OpenElectronicsLab/OpenHardwareExG_Shield/README

The OpenHardwareExG_Shield is a platform for ECG, EEG, EMG, ENG, EOG, and
evoked potential applications using an Arduino.

http://openelectronicslab.github.io/OpenHardwareExG_Shield/

Example firmware can be found at:

https://github.com/OpenElectronicsLab/OpenHardwareExG_Shield_Arduino_Library
