OpenElectronicsLab/OpenHardwareExG_Shield/OpenHardwareExG_Shield_Test_Harness/kicad-files/OpenHardwareExG_Shield_Test_Board.bom.csv

ref | value | footprint | partnum | supplier
C1 | 10uF | SM0805 | LMK212B7106KG-TD | mouser
C2 | 100nF | SM0603 | VJ0603Y104JXJPW1BC | mouser
C3 | 100nF | SM0603 | VJ0603Y104JXJPW1BC | mouser
C4 | 100nF | SM0603 | VJ0603Y104JXJPW1BC | mouser
C5 | 10uF | SM0805 | LMK212B7106KG-TD | mouser
C6 | 100nF | SM0603 | VJ0603Y104JXJPW1BC | mouser
C7 | 100nF | SM0603 | VJ0603Y104JXJPW1BC | mouser
C8 | 100nF | SM0603 | VJ0603Y104JXJPW1BC | mouser
C9 | 100nF | SM0603 | VJ0603Y104JXJPW1BC | mouser
C10 | 10uF | SM0805 | LMK212B7106KG-TD | mouser
C11 | 10uF | SM0805 | LMK212B7106KG-TD | mouser
C12 | 100nF | SM0603 | VJ0603Y104JXJPW1BC | mouser
D1 | LED | LED-0603 | HT-193UYG-5592 | mouser
D2 | LED | LED-0603 | HT-193UYG-5592 | mouser
D3 | LED | LED-0603 | APTD1608SURCK | mouser
L1 | MH2029-221Y | SM0805 | MH2029-221Y | mouser
L3 | MH2029-221Y | SM0805 | MH2029-221Y | mouser
L4 | MH2029-221Y | SM0805 | MH2029-221Y | mouser
P1 | CONN_1 | POGO_PIN_BASE | PRT-09173 | sparkfun
P2 | CONN_1 | POGO_PIN_BASE | PRT-09173 | sparkfun
P3 | CONN_1 | POGO_PIN_BASE | PRT-09173 | sparkfun
P4 | CONN_1 | POGO_PIN_BASE | PRT-09173 | sparkfun
P5 | CONN_1 | POGO_PIN_BASE | PRT-09173 | sparkfun
P6 | CONN_1 | POGO_PIN_BASE | PRT-09173 | sparkfun
P7 | CONN_1 | POGO_PIN_BASE | PRT-09173 | sparkfun
P8 | CONN_1 | POGO_PIN_BASE | PRT-09173 | sparkfun
P9 | CONN_1 | POGO_PIN_BASE | PRT-09173 | sparkfun
P11 | CONN_1 | POGO_PIN_BASE | PRT-09173 | sparkfun
P12 | CONN_1 | POGO_PIN_BASE | PRT-09173 | sparkfun
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
R43 | 10k | SM0603 | RR0816P-103-D | mouser
R44 | 10k | SM0603 | RR0816P-103-D | mouser
SW1 | SW_PUSH | smt-tactile-button | B3SN-3012P | mouser
U1 | 74HC165 | SO16E | SN74HC165DR | mouser
U2 | 74HC165 | SO16E | SN74HC165DR | mouser
U3 | 74HC595PWR | TSSOP16 | SN74HC595PWR | mouser
U4 | 74HC165 | SO16E | SN74HC165DR | mouser
U5 | 74LS125 | SO14E | SN74LS125AD | mouser
U6 | TPS2095D | SO16E | TPS2095D | mouser
U8 | SI8661 | SO16W | Si8661BD-B-IS | mouser
