OpenElectronicsLab/OpenHardwareExG_Shield/kicad-files/ancillary-files/OpenHardwareExG_Shield-schematic.pdf

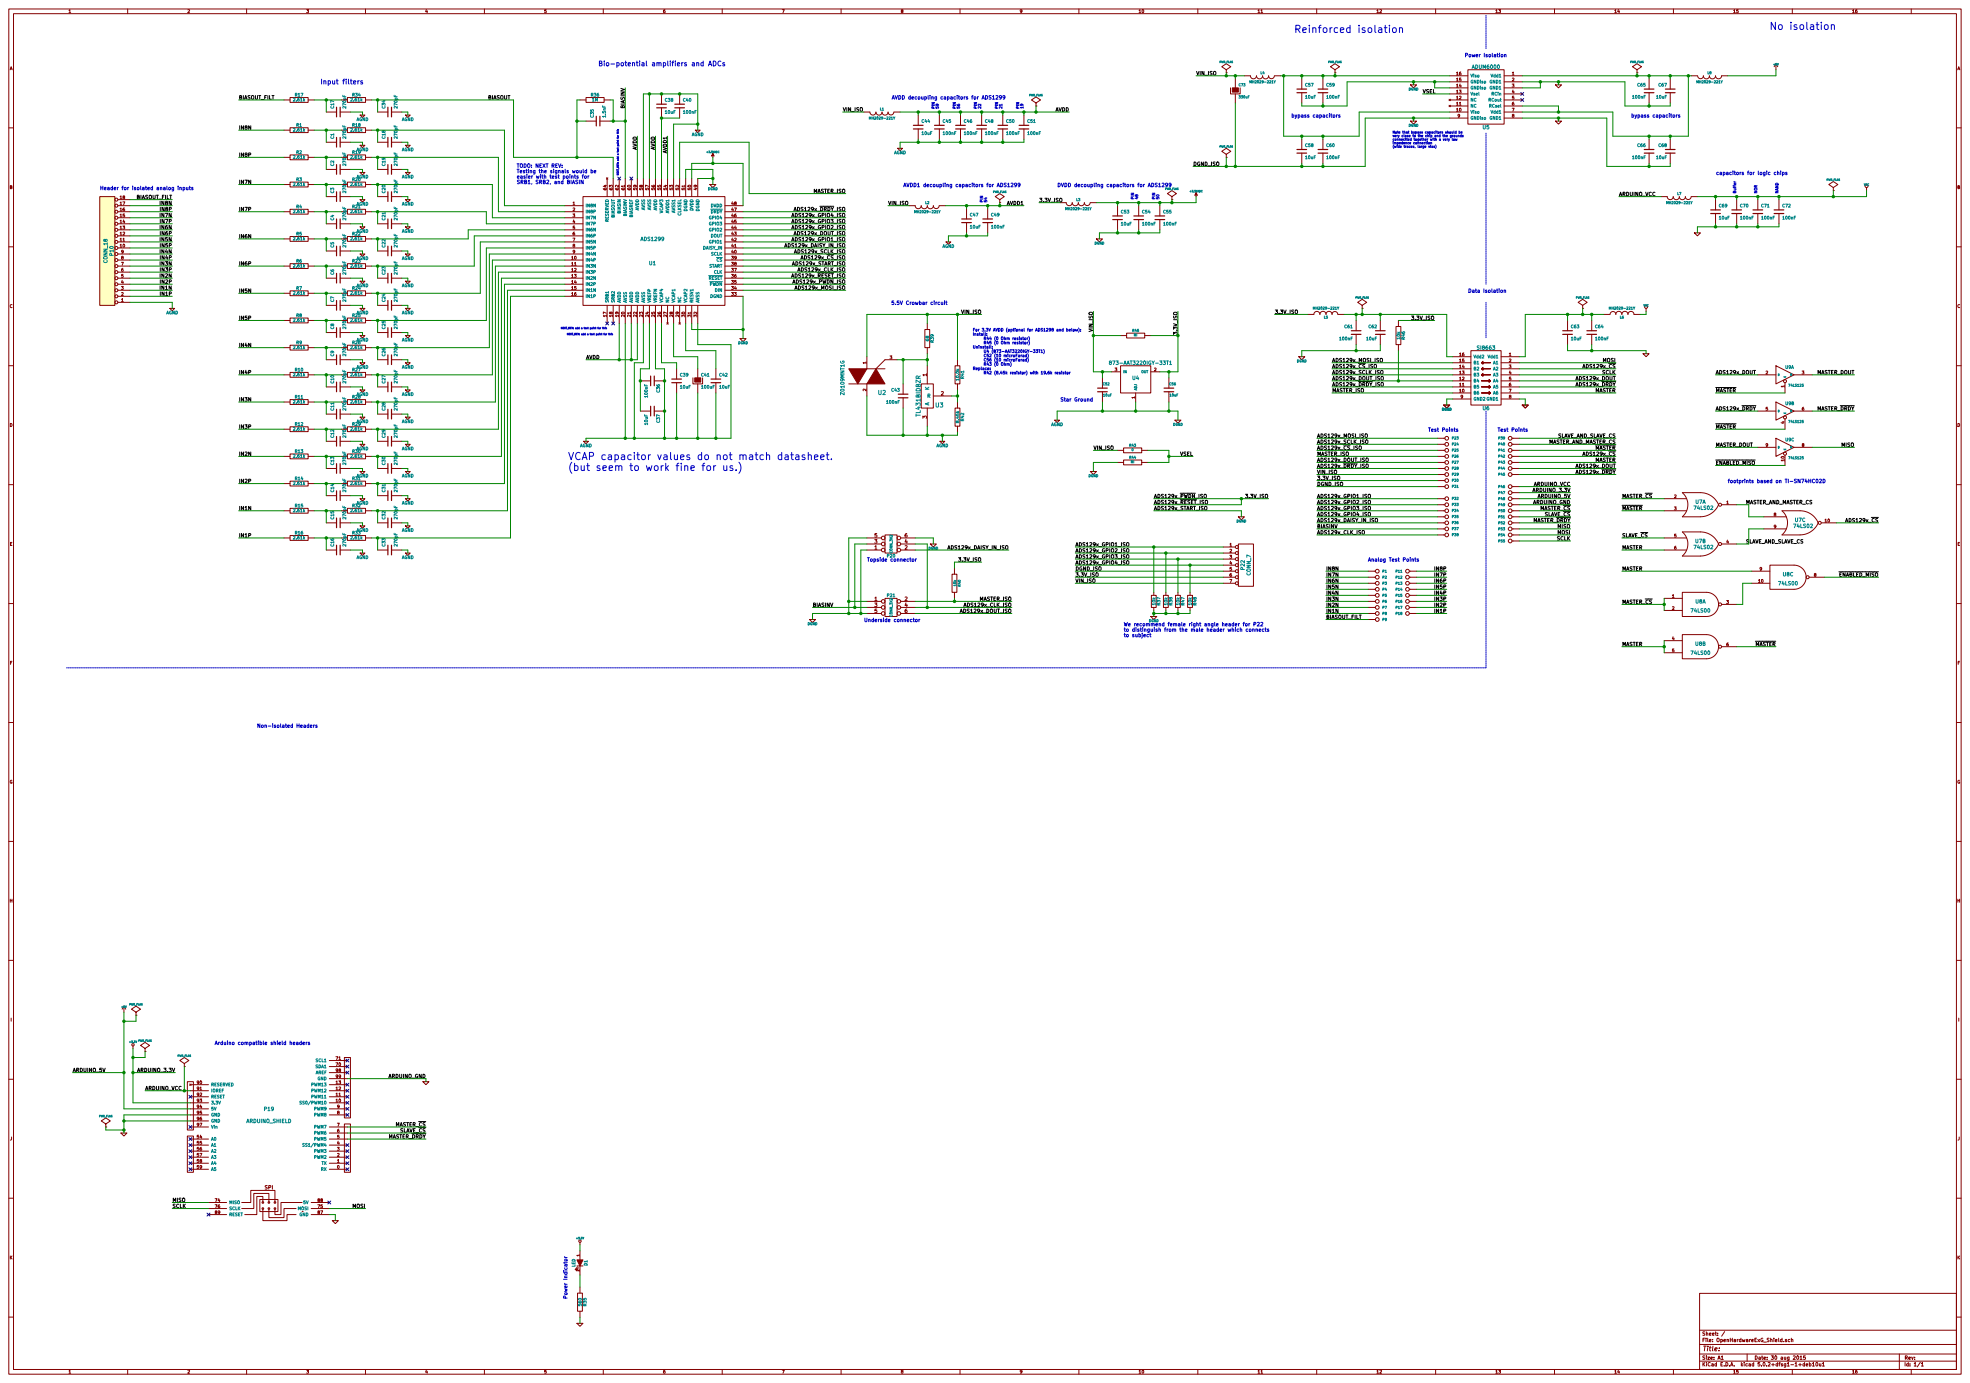
[picture p1: page 1]

(wide traces, large vias) VIN_ISO

Note that bypass capacitors should be
very close to the chip and the grounds
connectted together with a very low
impedence connection

DGND_ISO NEXT_REV: add a test point for this NEXT_REV: add a test point for this NEXT_REV: add a test point for this TODO: NEXT REV:

Testing the signals would be
easier with test points for

DVDD decoupling capacitors for ADS1299 C53

Header for isolated analog inputs
18 P10 CONN_18

For 3.3V AVDD (optional for ADS1298 and below):
Install:
R44 (0 Ohm resistor)
R45 (0 Ohm resistor) Uninstall:
U4 (873-AAT3220IGY-33T1)
C52 (10 microFarad)
C56 (10 microFarad)
R43 (0 Ohm) Replace:
R42 (8.45k resistor) with 19.6k resistor

VCAP capacitor values do not match datasheet.
(but seem to work fine for us.)

footprints based on TI-SN74HC02D

We recommend female right angle header for P22
to distinguish from the male header which connects
to subject

Non-isolated Headers Arduino compatible shield headers
