OpenElectronicsLab/OpenHardwareExG_Shield/OpenHardwareExG_Shield_Test_Harness/kicad-files/OpenHardwareExG_Shield_Test_Board.kicad_pcb

## KiCad design OpenHardwareExG_Shield_Test_Harness/kicad-files/OpenHardwareExG_Shield_Test_Board.kicad_pcb (2015-10-03)

Schematic: OpenHardwareExG_Shield_Test_Board.sch

Parts:
C1, C5, C10, C11: 10uF; SM0805
C2, C3, C4, C6, C7, C8, C9, C12: 100nF; SM0603
D1, D2, D3: LED; LED-0603
L1, L3, L4: MH2029-221Y; SM0805
P1, P2, P3, P4, P5, P6, P7, P8, P9, P11, P12, P13, P14, P15, P16, P17, P18, P23, P24, P25, P26, P27, P28, P29, P30, P31, P32, P33, P34, P35, P36, P37, P38, P39, P40, P41, P42, P43, P44, P45, P46, P47, P48, P49, P50, P51, P52, P53, P54, P55: CONN_1; POGO_PIN_BASE
P19: ARDUINO_SHIELD; arduino_shield_with_holes
P56: CONN_3X2; pin_array_3x2
P57: CONN_20X2; PIN_ARRAY_20X2
R1, R3, R5, R43, R44: 10k; SM0603
R2, R4, R6: 1k; SM0603
R7: 5.1K; SM0603
R8, R18, R19, R20, R21, R22, R23, R24, R25, R26, R27, R28, R29, R30, R31, R32: 100; SM0603
R9, R10, R11, R12, R13, R14, R15, R16, R34, R35, R36, R37, R38, R39: 1M; SM0805
R17, R33: 15k; SM0603
R40, R41, R42: 560; SM0603
SW1: SW_PUSH; smt-tactile-button
U1, U2, U4: 74HC165; SO16E
U3: 74HC595PWR; TSSOP16
U5: 74LS125; SO14E
U6: TPS2095D; SO16E
U8: SI8661; SO16W

Connections:
+3.3V: P19.93 (3.3V), U6.3 (IN2)
+5V: P19.88 (5V), P19.94 (5V), P56.4, U6.6 (IN3)
/3.3V_BOGUS_ISO: L1.2, P30.1, P57.3, P57.4, R3.1
/3.3V_BOGUS_ISO_DATA: C9.1, C10.1, L3.1, U8.16 (Vdd2)
/A1: P19.55 (A1), R5.2, R6.1
/A2: P19.56 (A2), R3.2, R4.1
/A3: P19.57 (A3), R1.2, R2.1
/A4: P19.58 (A4), R8.2
/ADS129x_CLK_BOGUS_ISO: P38.1, R35.1, U2.13 (C)
/ADS129x_DAISY_IN_BOGUS_ISO: P36.1, R34.1, U1.13 (C)
/ADS129x_DOUT: P44.1, U4.12 (B)
/ADS129x_DOUT_BOGUS_ISO: P27.1, R39.1, U2.11 (A)
/ADS129x_GPIO1_BOGUS_ISO: P32.1, R9.1, U1.3 (E)
/ADS129x_GPIO2_BOGUS_ISO: P33.1, R11.1, U1.4 (F)
/ADS129x_GPIO3_BOGUS_ISO: P34.1, R13.1, U1.5 (G)
/ADS129x_GPIO4_BOGUS_ISO: P35.1, R15.1, U1.6 (H)
/ADS129x_MOSI_BOGUS_ISO: P23.1, R10.1, U2.3 (E)
/ADS129x_SCLK_BOGUS_ISO: P24.1, R12.1, U2.4 (F)
/ADS129x_~CS~: P42.1, U4.14 (D)
/ADS129x_~CS~_BOGUS_ISO: P25.1, R14.1, U2.5 (G)
/ADS129x_~DRDY~: P45.1, U4.11 (A)
/ADS129x_~DRDY~_BOGUS_ISO: P28.1, R37.1, U2.12 (B)
/ARDUINO_VCC: C5.1, C6.1, C7.1, C8.1, D1.1, L4.2, P19.91 (IOREF), P56.2, R44.2, SW1.2, U3.16 (VCC), U4.16 (VCC), U6.2 (IN1)
/BIASINV: P37.1, R36.1, U1.12 (B)
/BIASOUT_FILT: P9.1, P19.59 (A5), R7.1
/ENABLE_SHIELD: U3.7 (QH), U6.4 (EN1), U6.8 (EN3), U6.13 (EN2)
/FAULT_LED: D3.1, U3.6 (QG)
/GO_BUTTON: R43.1, SW1.1, U4.6 (H)
/IN1N: P8.1, P57.37
/IN1N_LADDER: P57.38, R31.2, R32.2
/IN1P: P18.1, P57.39
/IN1P_LADDER: P57.40, R32.1, R33.1
/IN2N: P7.1, P57.33
/IN2N_LADDER: P57.34, R29.2, R30.2
/IN2P: P17.1, P57.35
/IN2P_LADDER: P57.36, R30.1, R31.1
/IN3N: P6.1, P57.29
/IN3N_LADDER: P57.30, R27.2, R28.2
/IN3P: P16.1, P57.31
/IN3P_LADDER: P57.32, R28.1, R29.1
/IN4N: P5.1, P57.25
/IN4N_LADDER: P57.26, R25.2, R26.2
/IN4P: P15.1, P57.27
/IN4P_LADDER: P57.28, R26.1, R27.1
/IN5N: P4.1, P57.21
/IN5N_LADDER: P57.22, R23.2, R24.2
/IN5P: P14.1, P57.23
/IN5P_LADDER: P57.24, R24.1, R25.1
/IN6N: P3.1, P57.17
/IN6N_LADDER: P57.18, R21.2, R22.2
/IN6P: P13.1, P57.19
/IN6P_LADDER: P57.20, R22.1, R23.1
/IN7N: P2.1, P57.13
/IN7N_LADDER: P57.14, R19.2, R20.2
/IN7P: P12.1, P57.15
/IN7P_LADDER: P57.16, R20.1, R21.1
/IN8N: P1.1, P57.9
/IN8N_LADDER: P57.10, R17.2, R18.2
/IN8P: P11.1, P57.11
/IN8P_LADDER: P57.12, R18.1, R19.1
/LED1: D1.2, R40.1
/LED2: D2.2, R41.1
/LED3: D3.2, R42.1
/MASTER: P43.1, U4.13 (C)
/MASTER_AND_MASTER_CS: P40.1, U4.4 (F)
/MASTER_BOGUS_ISO: P26.1, R16.1, U2.6 (H), U5.3 (O)
/MASTER_~CS~: P50.1, U3.1 (QB)
/MASTER_~DRDY~: P19.2 (PWM2), P52.1
/MIDDLE_CARRY: U1.9 (QH), U2.10 (SER)
/MISO: P19.74 (MISO), P53.1
/MOSI: P19.75 (MOSI), P54.1
/SCLK: P19.76 (SCLK), P55.1
/SHIELD_3.3V: P47.1, U6.14 (OUT2)
/SHIELD_5V: P48.1, U6.11 (OUT3)
/SHIELD_VCC: P46.1, U6.15 (OUT1)
/SHIFT_CARRY: U4.10 (SER), U8.7 (A6)
/SHIFT_CARRY_BOGUS_ISO: U2.9 (QH), U8.10 (B6)
/SHIFT_CLK: P19.8 (PWM8), U4.2 (CLK), U8.6 (A5)
/SHIFT_CLK_BOGUS_ISO: P56.3, U1.2 (CLK), U2.2 (CLK), U8.11 (B5)
/SHIFT_EXT_CARRY_BOGUS_ISO: P56.5, R38.1, U1.10 (SER)
/SHIFT_IN: P19.54 (A0), U4.9 (QH)
/SHIFT_OUT: P19.6 (PWM6), U3.14 (SER)
/SHIFT_OUT_RCLK: P19.5 (PWM5), U3.12 (RCLK)
/SHIFT_OUT_SRCLK: P19.4 (SS1/PWM4), U3.11 (SRCLK)
/SHIFT_OUT_~SRCLR~: P19.3 (PWM3), U3.10 (~SRCLR~)
/SHIFT_SH_~LD~: P19.9 (PWM9), U4.1 (SH_~LD~), U8.5 (A4)
/SHIFT_SH_~LD~_BOGUS_ISO: P56.1, U1.1 (SH_~LD~), U2.1 (SH_~LD~), U8.12 (B4)
/SIGNAL_A: U3.3 (QD), U8.2 (A1)
/SIGNAL_A_BOGUS_ISO: P57.6, U8.15 (B1)
/SIGNAL_A_LADDER: P57.5, R17.1
/SIGNAL_B: U3.4 (QE), U8.3 (A2)
/SIGNAL_B_BOGUS_ISO: P57.8, U8.14 (B2)
/SIGNAL_B_LADDER: P57.7, R33.2
/SLAVE_AND_SLAVE_CS: P39.1, U4.3 (E)
/SLAVE_~CS~: P51.1, U3.2 (QC)
/SUCCESS_LED: D2.1, U3.5 (QF)
/VCC_DATA: C11.1, C12.1, L4.1, U8.1 (Vdd1)
/VIN_BOGUS_ISO: P29.1, R5.1
/~MASTER~: P41.1, U4.5 (G)
/~SEND_TO_GND~_MASTER: U3.15 (QA), U8.4 (A3)
/~SEND_TO_GND~_MASTER_BOGUS_ISO: U5.1 (E), U8.13 (B3)
/~SHIELD_SHORTED~: P19.7 (PWM7), R44.1, U6.12 (~OCB~), U6.16 (~OCA~)
GND: C1.2, C2.2, C3.2, C4.2, C9.2, C10.2, P31.1, P57.1, P57.2, R1.1, R8.1, R9.2, R10.2, R11.2, R12.2, R13.2, R14.2, R15.2, R16.2, R34.2, R35.2, R36.2, R37.2, R38.2, R39.2, U1.8 (GND), U1.15 (CLK_INH), U2.8 (GND), U2.15 (CLK_INH), U5.2 (D), U5.7 (GND), U8.9 (GND2)
GNDPWR: C5.2, C6.2, C7.2, C8.2, C11.2, C12.2, P19.87 (GND), P19.95 (GND), P19.96 (GND), P19.99 (GND), P49.1, P56.6, R2.2, R4.2, R6.2, R7.2, R40.2, R41.2, R42.2, R43.2, U3.8 (GND), U3.13 (~OE~), U4.8 (GND), U4.15 (CLK_INH), U6.1 (GNDA), U6.5 (GNDB), U6.7 (IN4), U6.9 (EN4), U8.8 (GND1)
VCC: C1.1, C2.1, C3.1, C4.1, L1.1, L3.2, U1.11 (A), U1.14 (D), U1.16 (VCC), U2.14 (D), U2.16 (VCC), U5.14 (VCC)

Notes on the sheet:
Power Indicator
Non-isolated Headers
Arduino compatible shield headers
No isolation
bogus isolation
Bogus Data Isolation
Test Pogos
SHIFT
Buffer
capacitors for logic chips
Success Indicator
Fault Indicator

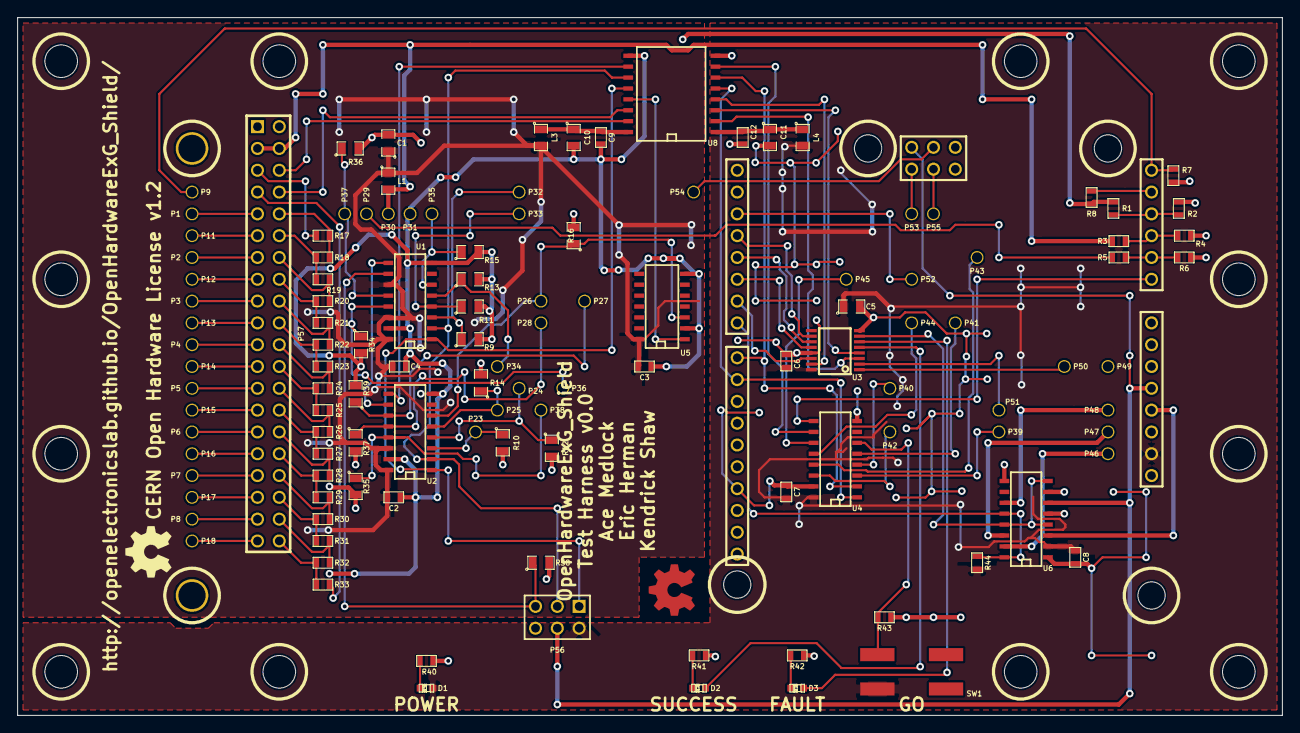
[picture p2: board OpenHardwareExG_Shield_Test_Board.kicad_pcb from above]

Board: 4 copper layers, 147.3 x 81.3 mm, 137 parts (0 on the bottom side), 105 nets.

Other parts of the board:
Hole_M3, Hole_M3#2, Hole_M3#3, Hole_M3#4, Hole_M3#5, Hole_M3#6, Hole_M3#7, Hole_M3#8, Hole_M3#9, Hole_M3#10, Hole_M3#11, Hole_M3#12, Hole_M3#13, Hole_M3#14: VAL**; Hole_M3
