OpenElectronicsLab/OpenHardwareExG_Shield/kicad-files/OpenHardwareExG_Shield.kicad_pcb

## KiCad design kicad-files/OpenHardwareExG_Shield.kicad_pcb (2016-09-04)

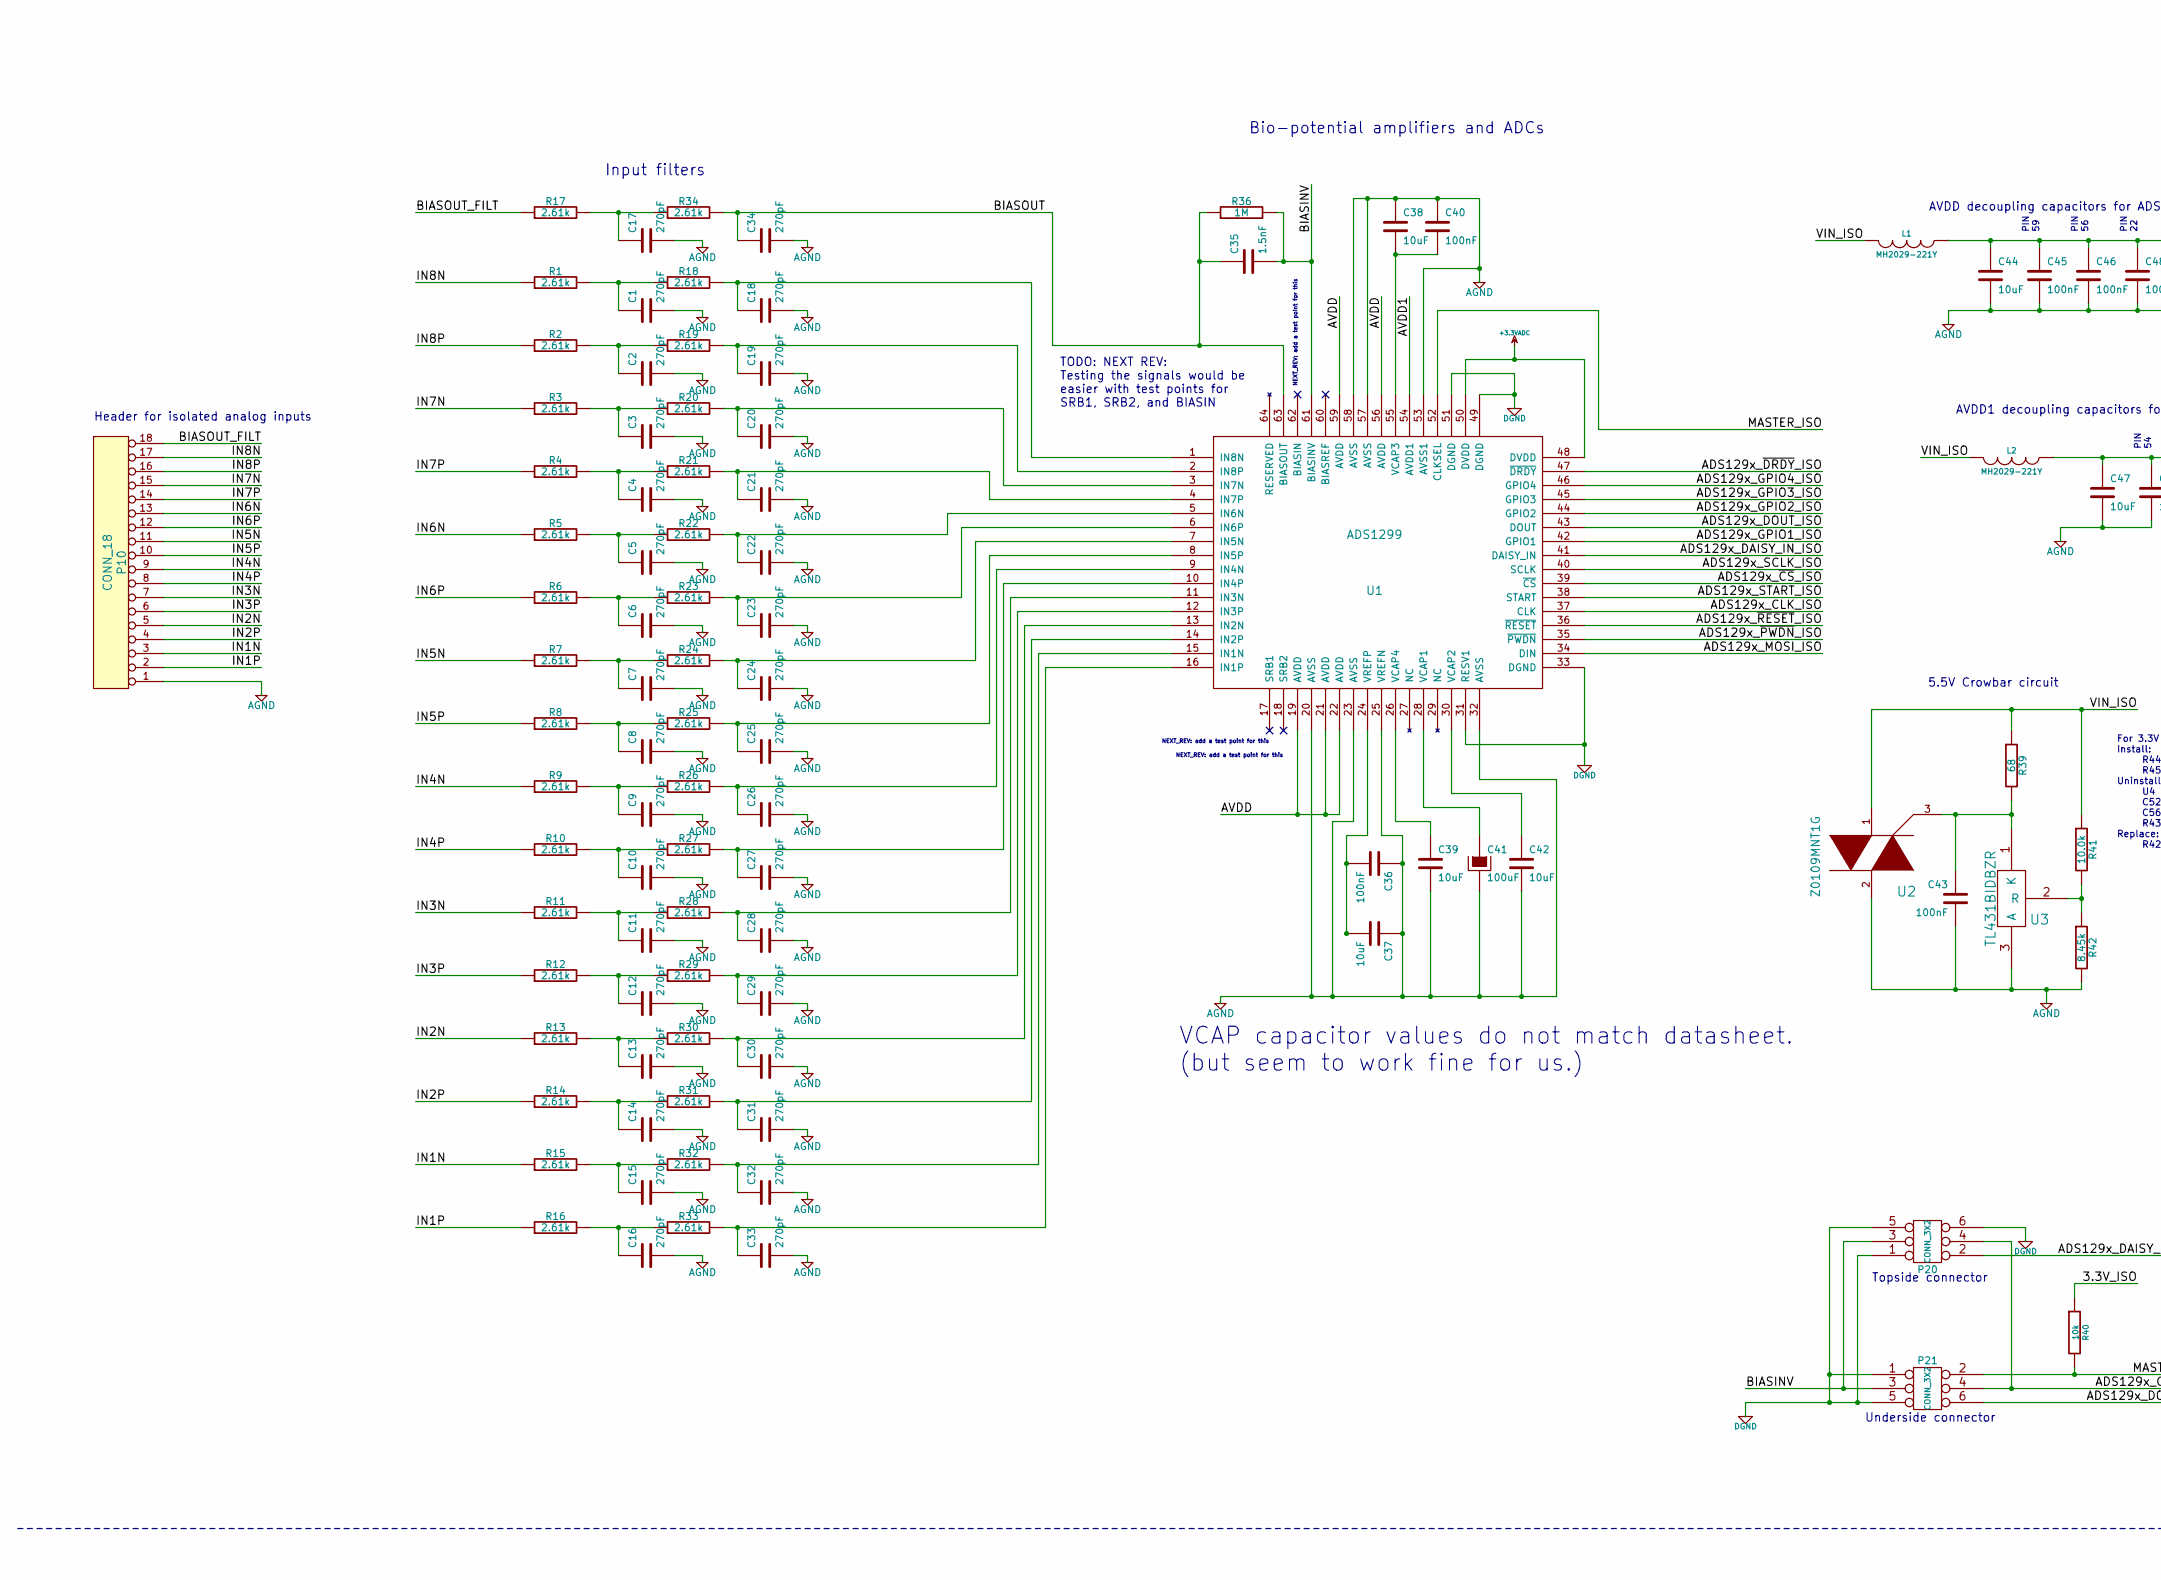
[picture p3: schematic OpenHardwareExG_Shield.sch, part in row 1, column 1]

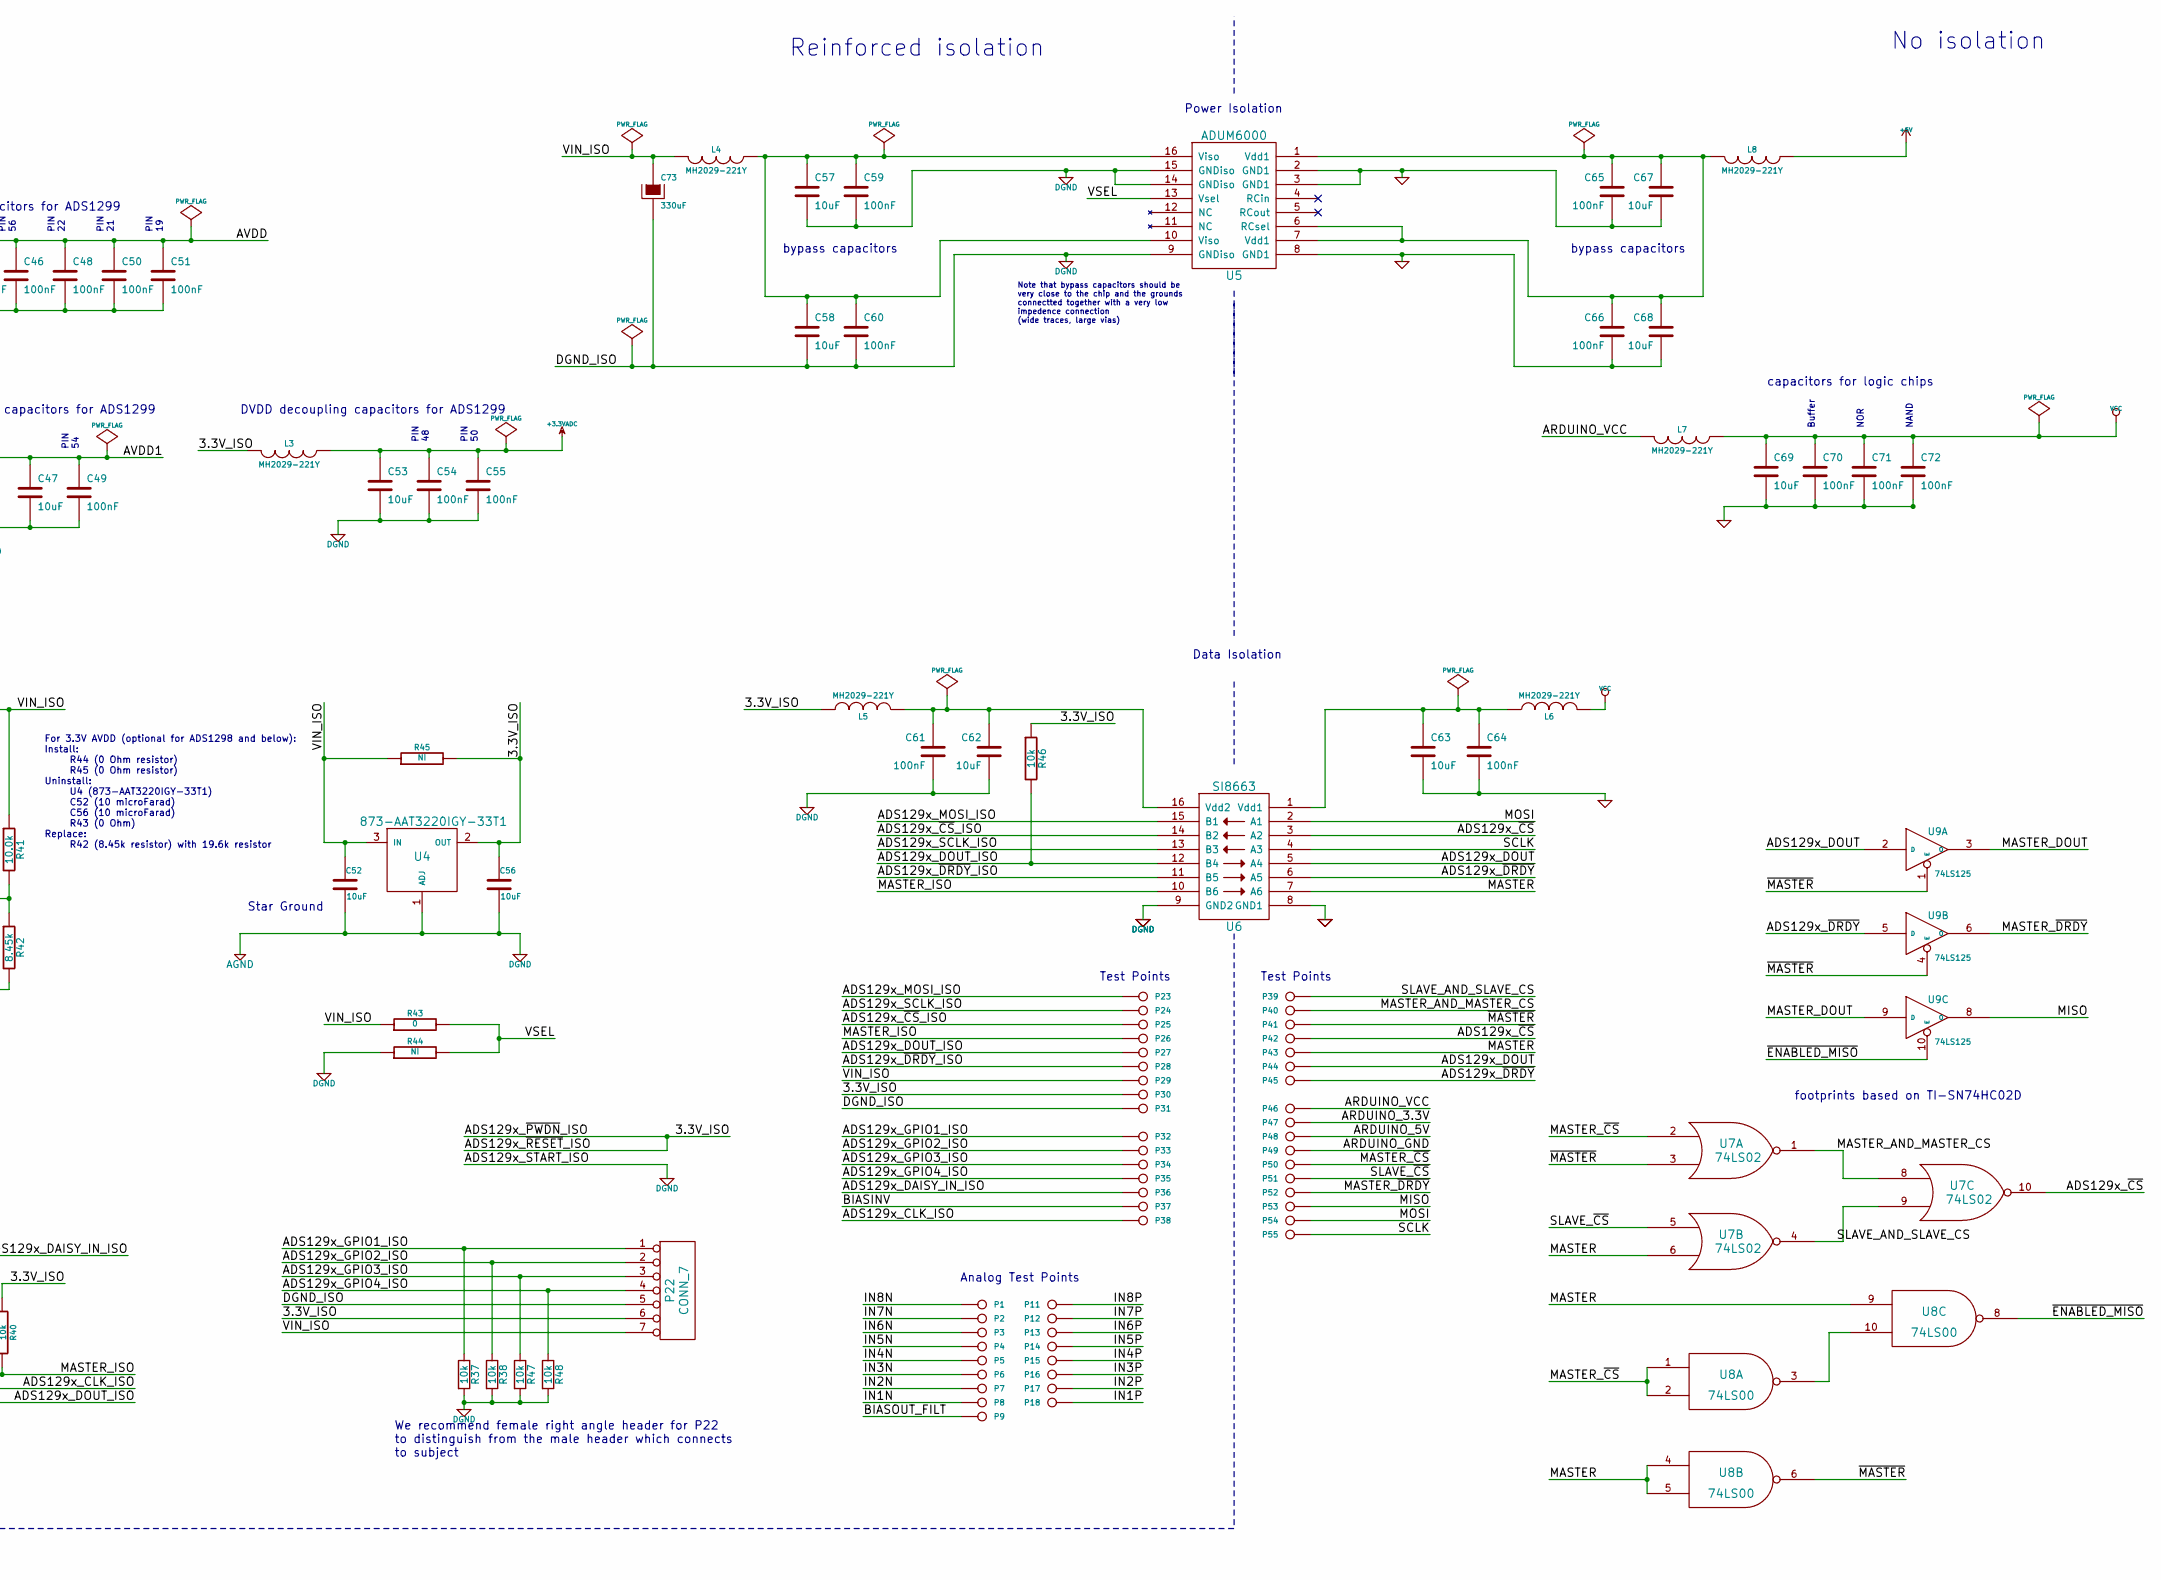
[picture p4: schematic OpenHardwareExG_Shield.sch, part in row 1, column 2]

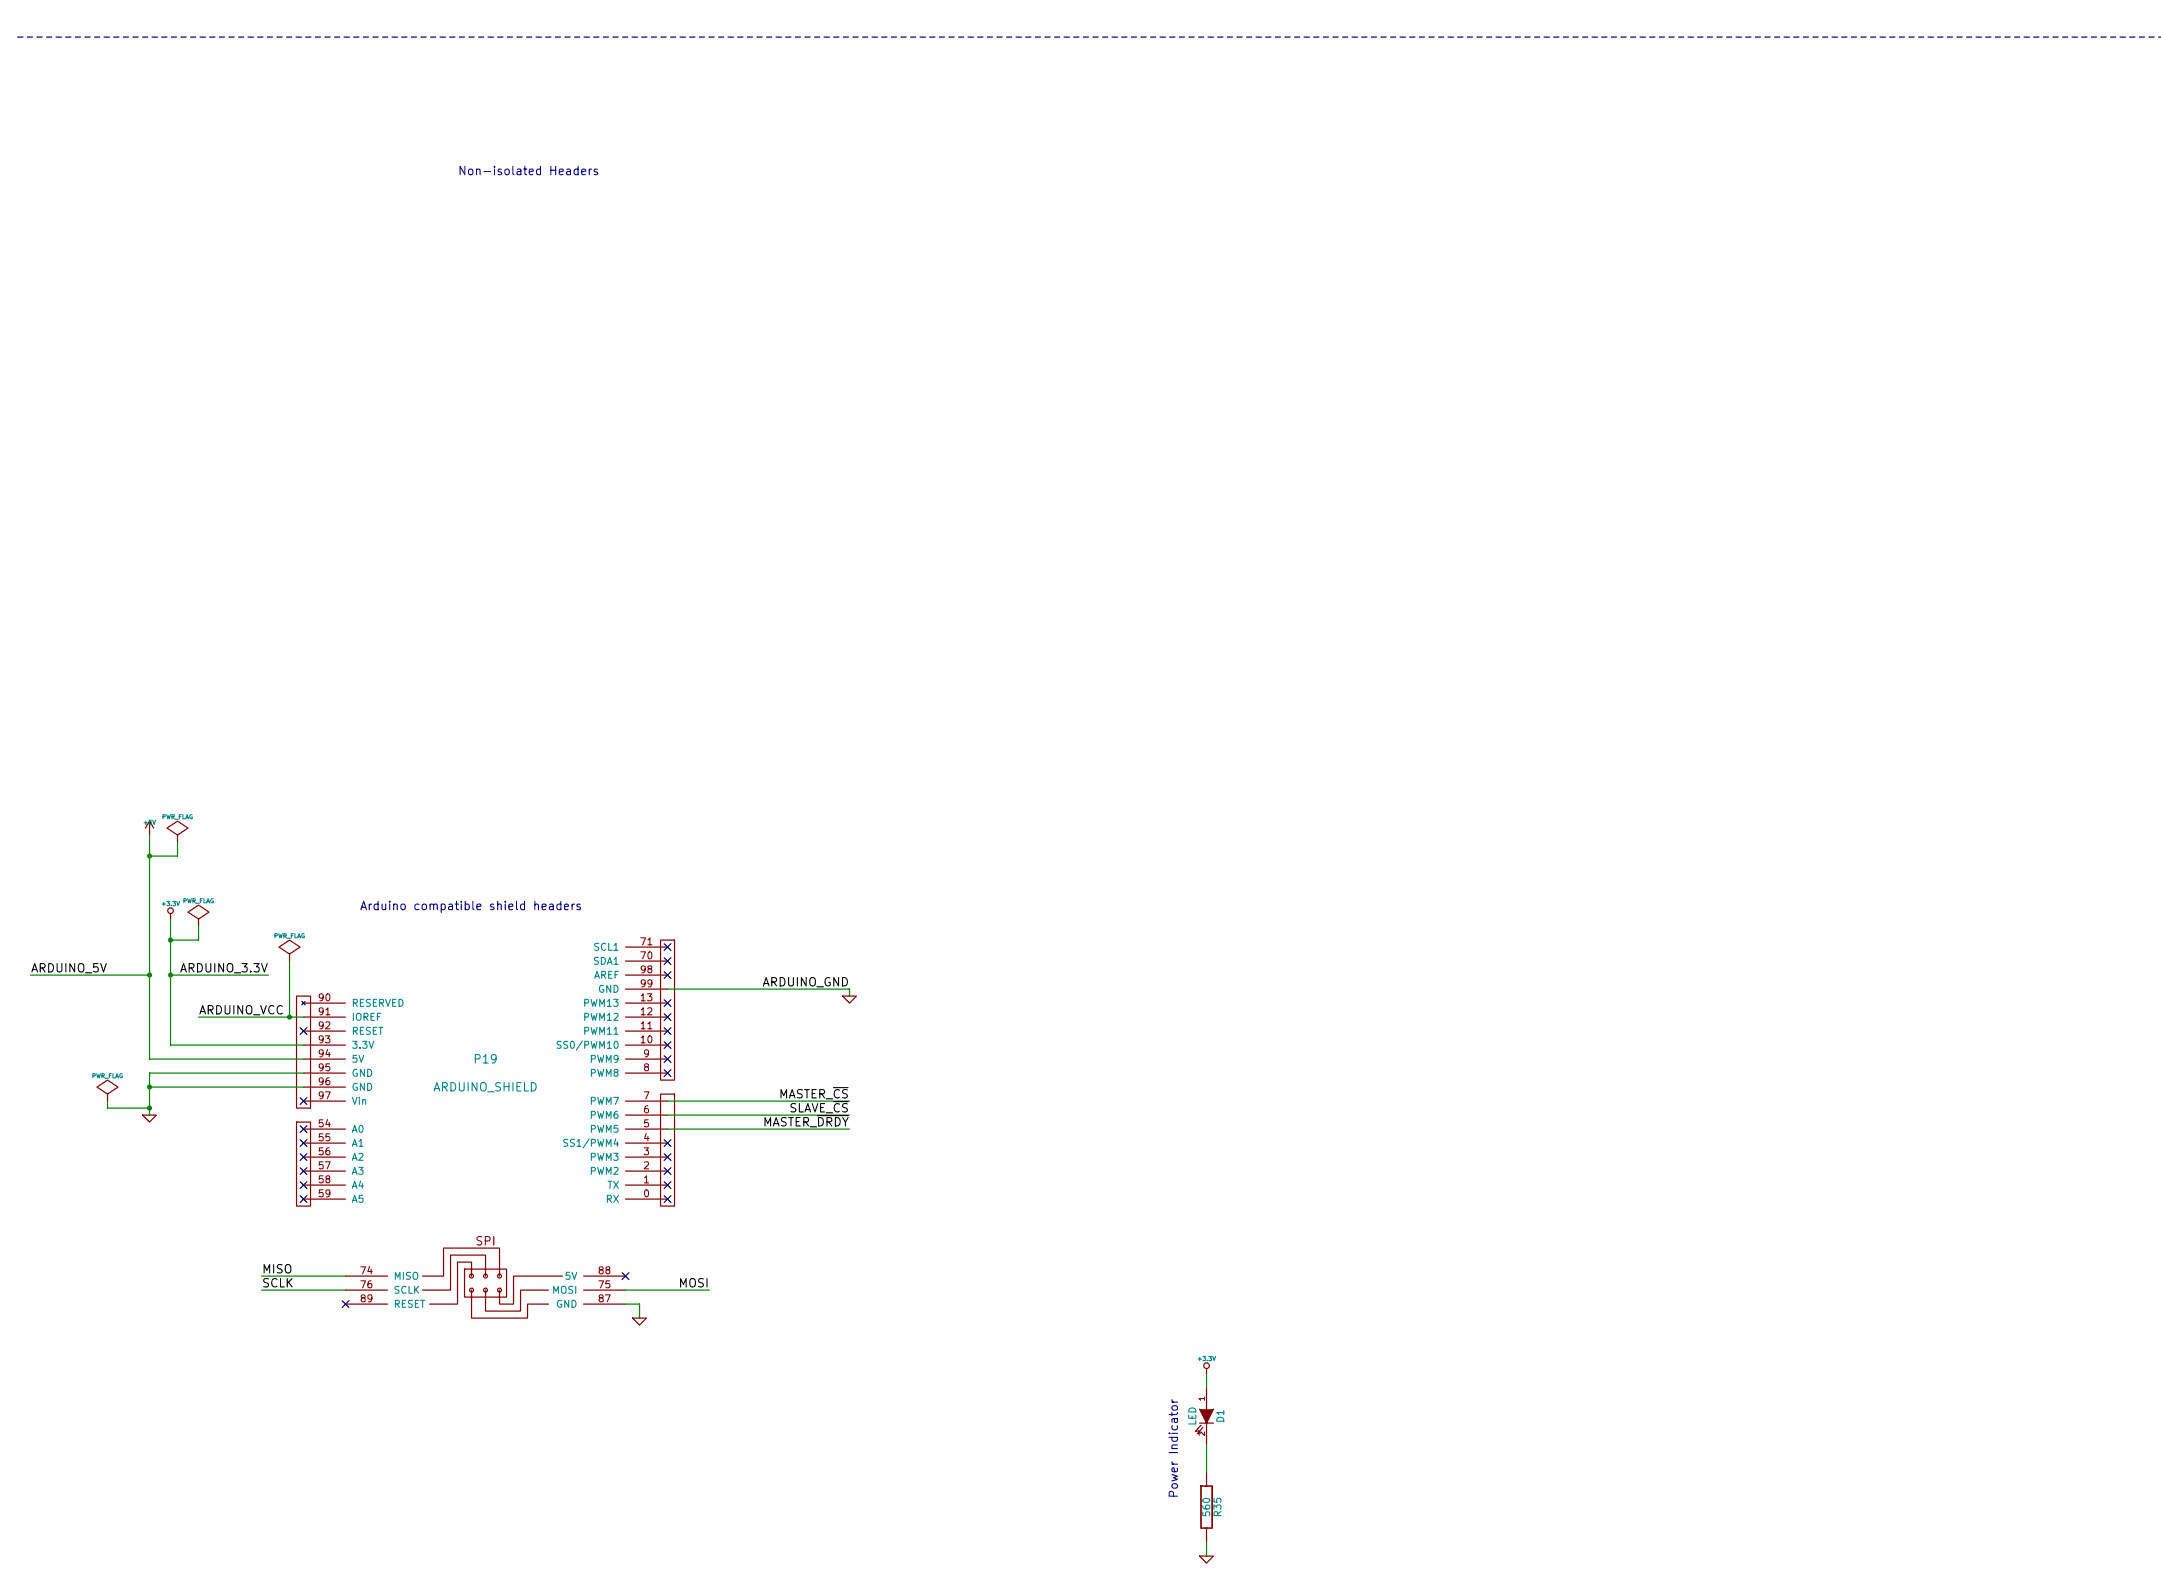
[picture p5: schematic OpenHardwareExG_Shield.sch, part in row 2, column 1]

Parts:
C1, C2, C3, C4, C5, C6, C7, C8, C9, C10, C11, C12, C13, C14, C15, C16, C17, C18, C19, C20, C21, C22, C23, C24, C25, C26, C27, C28, C29, C30, C31, C32, C33, C34: 270pF; SM0603
C35: 1.5nF; SM0603
C36, C40, C43, C45, C46, C48, C49, C50, C51, C54, C55, C59, C60, C61, C64, C65, C66, C70, C71, C72: 100nF; SM0603
C37, C38, C39, C42, C44, C47, C52, C53, C56, C57, C58, C62, C63, C67, C68, C69: 10uF; SM0805
C41: 100uF; SM2512
C73: 330uF; c_tant_D
D1: LED; LED-0603
L1, L2, L3, L4, L5, L6, L7, L8: MH2029-221Y; SM0805
P1, P2, P3, P4, P5, P6, P7, P8, P9, P11, P12, P13, P14, P15, P16, P17, P18, P23, P24, P25, P26, P27, P28, P29, P30, P31, P32, P33, P34, P35, P36, P37, P38, P39, P40, P41, P42, P43, P44, P45, P46, P47, P48, P49, P50, P51, P52, P53, P54, P55: CONN_1; POGO_PAD
P10: CONN_18; PIN_ARRAY_18x1
P19: ARDUINO_SHIELD; arduino_shield_with_holes
P20: CONN_3X2; 54202-G0803ALF
P21: CONN_3X2; 89898-303LF
P22: CONN_7; PIN_ARRAY_7x1
R1, R2, R3, R4, R5, R6, R7, R8, R9, R10, R11, R12, R13, R14, R15, R16, R17, R18, R19, R20, R21, R22, R23, R24, R25, R26, R27, R28, R29, R30, R31, R32, R33, R34: 2.61k; SM0603
R35: 560; SM0603
R36: 1M; SM0805
R37, R38, R47, R48: 10k; R_0603
R39: 68; SM0603
R40, R46: 10k; SM0603
R41: 10.0k; SM0603
R42: 8.45k; SM0603
R43: 0; SM0603
R44, R45: NI; SM0603
U1: ADS1299; TQFP_64
U2: Z0109MNT1G; SOT223
U3: TL431BIDBZR; SOT23
U4: 873-AAT3220IGY-33T1; SOT23
U5: ADUM6000; SO16W
U6: SI8663; SO16W
U7: 74LS02; SO14E
U8: 74LS00; SO14E
U9: 74LS125; SO14E

Connections:
+3.3V: D1.1 (A), P19.93 (3.3V), P47.1
+3.3VADC: C53.1, C54.1, C55.1, L3.1, U1.48 (DVDD), U1.50 (DVDD)
+5V: L8.2, P19.94 (5V), P48.1
/3.3V_ISO: C56.1, L3.2, L5.2, P22.6, P30.1, R40.1, R45.2, R46.1, U1.35 (~PWDN~), U1.36 (~RESET~), U4.2 (OUT)
/ADS129x_CLK_ISO: P20.4, P21.4, P38.1, U1.37 (CLK)
/ADS129x_DAISY_IN_ISO: P20.2, P36.1, U1.41 (DAISY_IN)
/ADS129x_DOUT: P44.1, U6.5 (A4), U9.2 (D)
/ADS129x_DOUT_ISO: P21.6, P27.1, R46.2, U1.43 (DOUT), U6.12 (B4)
/ADS129x_GPIO1_ISO: P22.1, P32.1, R37.1, U1.42 (GPIO1)
/ADS129x_GPIO2_ISO: P22.2, P33.1, R38.1, U1.44 (GPIO2)
/ADS129x_GPIO3_ISO: P22.3, P34.1, R47.1, U1.45 (GPIO3)
/ADS129x_GPIO4_ISO: P22.4, P35.1, R48.1, U1.46 (GPIO4)
/ADS129x_MOSI_ISO: P23.1, U1.34 (DIN), U6.15 (B1)
/ADS129x_SCLK_ISO: P24.1, U1.40 (SCLK), U6.13 (B3)
/ADS129x_~CS~: P42.1, U6.3 (A2), U7.10
/ADS129x_~CS~_ISO: P25.1, U1.39 (~CS~), U6.14 (B2)
/ADS129x_~DRDY~: P45.1, U6.6 (A5), U9.5 (D)
/ADS129x_~DRDY~_ISO: P28.1, U1.47 (~DRDY~), U6.11 (B5)
/ARDUINO_VCC: L7.2, P19.91 (IOREF), P46.1
/AVDD: C44.1, C45.1, C46.1, C48.1, C50.1, C51.1, L1.1, U1.19 (AVDD), U1.21 (AVDD), U1.22 (AVDD), U1.56 (AVDD), U1.59 (AVDD)
/AVDD1: C47.1, C49.1, L2.1, U1.54 (AVDD1)
/BIASINV: C35.2, P20.3, P21.3, P37.1, R36.2, U1.61 (BIASINV)
/BIASOUT: C34.1, C35.1, R34.2, R36.1, U1.63 (BIASOUT)
/BIASOUT_FILT: P9.1, P10.18, R17.1
/IN1N: P8.1, P10.3, R15.1
/IN1P: P10.2, P18.1, R16.1
/IN2N: P7.1, P10.5, R13.1
/IN2P: P10.4, P17.1, R14.1
/IN3N: P6.1, P10.7, R11.1
/IN3P: P10.6, P16.1, R12.1
/IN4N: P5.1, P10.9, R9.1
/IN4P: P10.8, P15.1, R10.1
/IN5N: P4.1, P10.11, R7.1
/IN5P: P10.10, P14.1, R8.1
/IN6N: P3.1, P10.13, R5.1
/IN6P: P10.12, P13.1, R6.1
/IN7N: P2.1, P10.15, R3.1
/IN7P: P10.14, P12.1, R4.1
/IN8N: P1.1, P10.17, R1.1
/IN8P: P10.16, P11.1, R2.1
/MASTER: P43.1, U6.7 (A6), U7.6, U8.4, U8.5, U8.9
/MASTER_AND_MASTER_CS: P40.1, U7.1, U7.8
/MASTER_DOUT: U9.3 (O), U9.9 (D)
/MASTER_ISO: P21.2, P26.1, R40.2, U1.52 (CLKSEL), U6.10 (B6)
/MASTER_~CS~: P19.7 (PWM7), P50.1, U7.2, U8.1, U8.2
/MASTER_~DRDY~: P19.5 (PWM5), P52.1, U9.6 (O)
/MISO: P19.74 (MISO), P53.1, U9.8 (O)
/MOSI: P19.75 (MOSI), P54.1, U6.2 (A1)
/SCLK: P19.76 (SCLK), P55.1, U6.4 (A3)
/SLAVE_AND_SLAVE_CS: P39.1, U7.4, U7.9
/SLAVE_~CS~: P19.6 (PWM6), P51.1, U7.5
/VIN_ISO: C52.1, C73.1, L1.2, L2.2, L4.2, P22.7, P29.1, R39.1, R41.1, R43.1, R45.1, U2.1, U4.3 (IN)
/VSEL: R43.2, R44.2, U5.13 (Vsel)
/~ENABLED_MISO~: U8.8, U9.10 (E)
/~MASTER~: P41.1, U7.3, U8.6, U9.1 (E), U9.4 (E)
AGND: C1.2, C2.2, C3.2, C4.2, C5.2, C6.2, C7.2, C8.2, C9.2, C10.2, C11.2, C12.2, C13.2, C14.2, C15.2, C16.2, C17.2, C18.2, C19.2, C20.2, C21.2, C22.2, C23.2, C24.2, C25.2, C26.2, C27.2, C28.2, C29.2, C30.2, C31.2, C32.2, C33.2, C34.2, C36.1, C37.1, C38.1, C39.2, C40.1, C41.2, C42.2, C43.2, C44.2, C45.2, C46.2, C47.2, C48.2, C49.2, C50.2, C51.2, C52.2, C53.2, C54.2, C55.2, C56.2, C57.2, C58.2, C59.2, C60.2, C61.2, C62.2, C73.2, P10.1, P20.1, P20.5, P20.6, P21.1, P21.5, P22.5, P31.1, R37.2, R38.2, R42.2, R44.1, R47.2, R48.2, U1.20 (AVSS), U1.23 (AVSS), U1.25 (VREFN), U1.31 (RESV1), U1.32 (AVSS), U1.33 (DGND), U1.38 (START), U1.49 (DGND), U1.51 (DGND), U1.53 (AVSS1), U1.57 (AVSS), U1.58 (AVSS), U2.2, U3.3 (A), U4.1 (ADJ), U5.9 (GNDiso), U5.14 (GNDiso), U5.15 (GNDiso), U6.9 (GND2)
GND: C63.2, C64.2, C65.2, C66.2, C67.2, C68.2, C69.2, C70.2, C71.2, C72.2, P19.87 (GND), P19.95 (GND), P19.96 (GND), P19.99 (GND), P49.1, R35.2, U5.2 (GND1), U5.3 (GND1), U5.8 (GND1), U6.8 (GND1), U7.7 (GND), U8.7 (GND), U9.7 (GND)
unnamed: C1.1, R1.2, R18.1
unnamed: C2.1, R2.2, R19.1
unnamed: C3.1, R3.2, R20.1
unnamed: C4.1, R4.2, R21.1
unnamed: C5.1, R5.2, R22.1
unnamed: C6.1, R6.2, R23.1
unnamed: C7.1, R7.2, R24.1
unnamed: C8.1, R8.2, R25.1
unnamed: C9.1, R9.2, R26.1
unnamed: C10.1, R10.2, R27.1
unnamed: C11.1, R11.2, R28.1
unnamed: C12.1, R12.2, R29.1
unnamed: C13.1, R13.2, R30.1
unnamed: C14.1, R14.2, R31.1
unnamed: C15.1, R15.2, R32.1
unnamed: C16.1, R16.2, R33.1
unnamed: C17.1, R17.2, R34.1
unnamed: C18.1, R18.2, U1.1 (IN8N)
unnamed: C19.1, R19.2, U1.2 (IN8P)
unnamed: C20.1, R20.2, U1.3 (IN7N)
unnamed: C21.1, R21.2, U1.4 (IN7P)
unnamed: C22.1, R22.2, U1.5 (IN6N)
unnamed: C23.1, R23.2, U1.6 (IN6P)
unnamed: C24.1, R24.2, U1.7 (IN5N)
unnamed: C25.1, R25.2, U1.8 (IN5P)
unnamed: C26.1, R26.2, U1.9 (IN4N)
unnamed: C27.1, R27.2, U1.10 (IN4P)
unnamed: C28.1, R28.2, U1.11 (IN3N)
unnamed: C29.1, R29.2, U1.12 (IN3P)
unnamed: C30.1, R30.2, U1.13 (IN2N)
unnamed: C31.1, R31.2, U1.14 (IN2P)
unnamed: C32.1, R32.2, U1.15 (IN1N)
unnamed: C33.1, R33.2, U1.16 (IN1P)
unnamed: C36.2, C37.2, U1.24 (VREFP)
unnamed: C38.2, C40.2, U1.55 (VCAP3)
unnamed: C39.1, U1.26 (VCAP4)
unnamed: C41.1, U1.28 (VCAP1)
unnamed: C42.1, U1.30 (VCAP2)
unnamed: C43.1, R39.2, U2.3, U3.1 (K)
unnamed: C57.1, C58.1, C59.1, C60.1, L4.1, U5.10 (Viso), U5.16 (Viso)
unnamed: C61.1, C62.1, L5.1, U6.16 (Vdd2)
unnamed: C63.1, C64.1, L6.1, U6.1 (Vdd1)
unnamed: C65.1, C66.1, C67.1, C68.1, L8.1, U5.1 (Vdd1), U5.6 (RCsel), U5.7 (Vdd1)
unnamed: D1.2 (K), R35.1
unnamed: R41.2, R42.1, U3.2 (R)
unnamed: U8.3, U8.10
VCC: C69.1, C70.1, C71.1, C72.1, L6.2, L7.1, U7.14 (VCC), U8.14 (VCC), U9.14 (VCC)

Notes on the sheet:
Power Indicator
Non-isolated Headers
Arduino compatible shield headers
Header for isolated analog inputs
Input filters
Bio-potential amplifiers and ADCs
5.5V Crowbar circuit
No isolation
Reinforced isolation
PIN 48
PIN 50
DVDD decoupling capacitors for ADS1299
Data Isolation
Power Isolation
AVDD1 decoupling capacitors for ADS1299
PIN 54
PIN 19
PIN 21
PIN 22
PIN 56
PIN 59
AVDD decoupling capacitors for ADS1299
Underside connector
Topside connector
NAND
NOR
Buffer
capacitors for logic chips
Note that bypass capacitors should be very close to the chip and the grounds connectted together with a very low impedence connection (wide traces, large vias)
bypass capacitors
Test Points
Analog Test Points
footprints based on TI-SN74HC02D
Star Ground
For 3.3V AVDD (optional for ADS1298 and below): Install: R44 (0 Ohm resistor) R45 (0 Ohm resistor) Uninstall: U4 (873-AAT3220IGY-33T1) C52 (10 microFarad) C56 (10 microFarad) R43 (0 Ohm) Replace: R42 (8.45k resistor) with 19.6k resistor
VCAP capacitor values do not match datasheet. (but seem to work fine for us.)
We recommend female right angle header for P22 to distinguish from the male header which connects to subject
NEXT_REV: add a test point for this
TODO: NEXT REV: Testing the signals would be easier with test points for SRB1, SRB2, and BIASIN

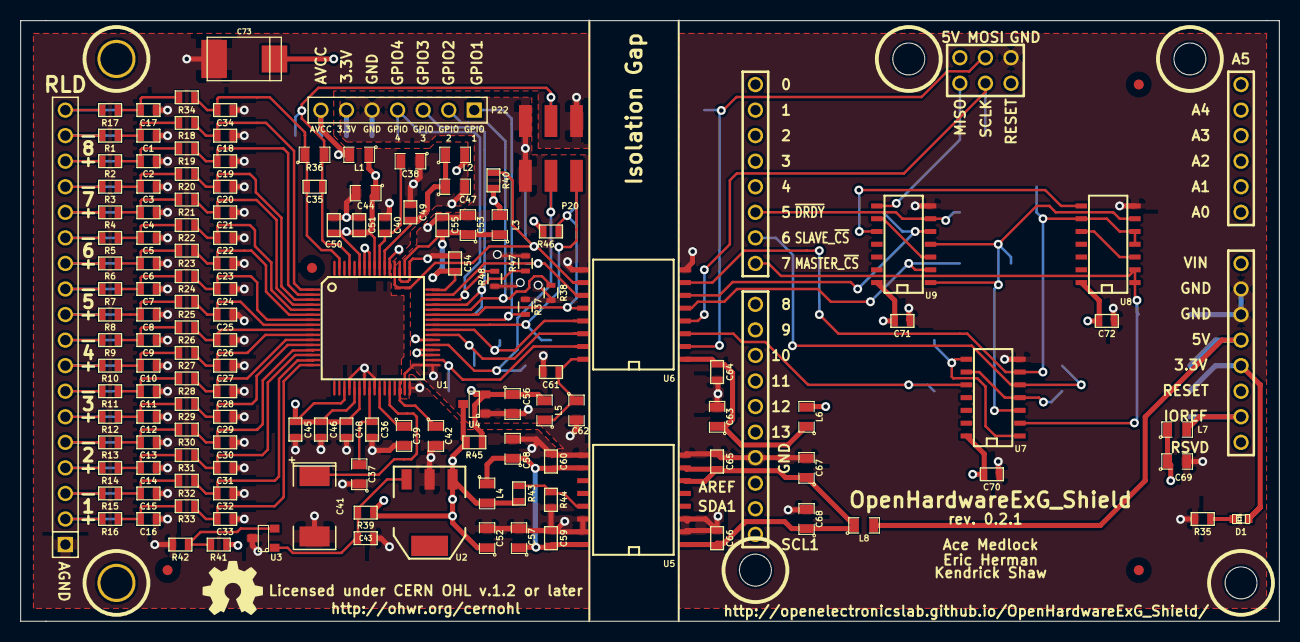
[picture p6: board OpenHardwareExG_Shield.kicad_pcb from above]

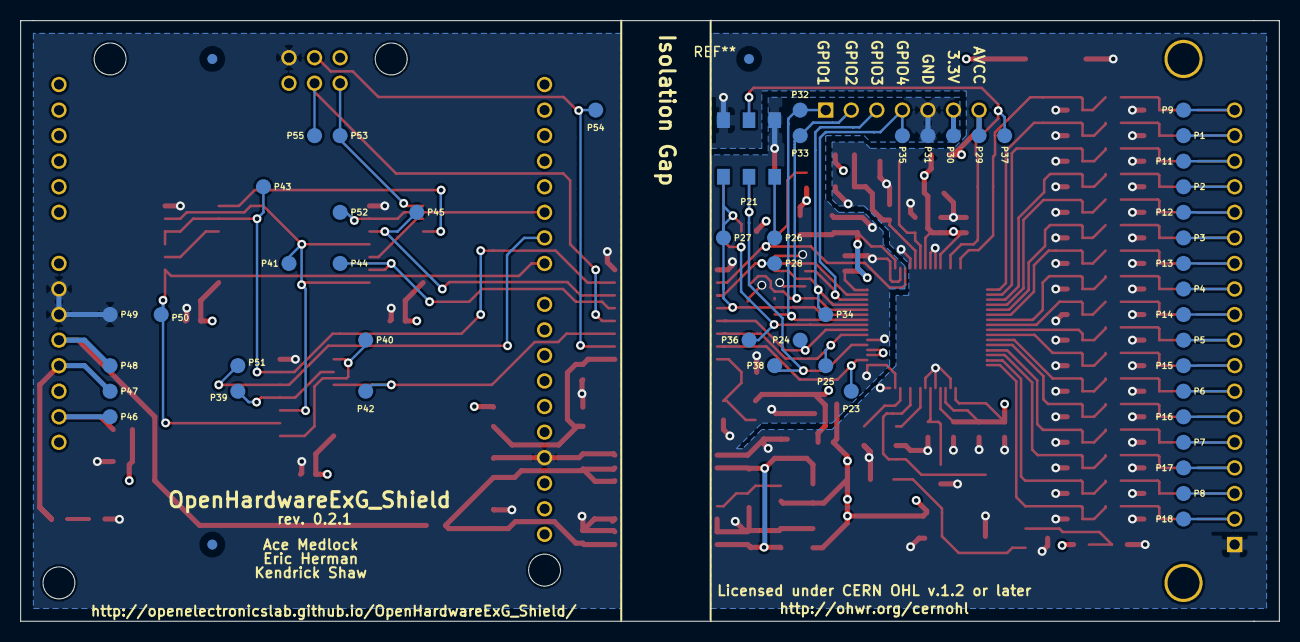
[picture p7: board OpenHardwareExG_Shield.kicad_pcb from below]

Board: 4 copper layers, 125.1 x 59.7 mm, 196 parts (51 on the bottom side), 104 nets.

Other parts of the board:
Hole_M3, Hole_M3#2: VAL**; Hole_M3
