OpenElectronicsLab/OpenHardwareExG_Shield/(commit log)

2014-08-30 initial rough schematic of the OpenHardwareExG_Shield
    [OpenHardwareExG_Shield.sch]
2014-09-27 added start of master/slave detection
    [OpenHardwareExG_Shield.sch]
2014-10-05 remove BIAS jumpers header
    [OpenHardwareExG_Shield.sch]
2014-10-11 tidy up wires
    [OpenHardwareExG_Shield.sch]
2014-10-11 remove filter bypass jumpers
    [OpenHardwareExG_Shield.sch]
2014-10-11 fix label MASTER -> MASTER_ISO
    [OpenHardwareExG_Shield.sch]
2014-10-11 connected DRDY, DOUT, and CS for MASTER and SLAVEs
    [OpenHardwareExG_Shield.sch]
2014-10-18 add more labels
    [OpenHardwareExG_Shield.sch]
2014-10-18 added capacitors for logic chips
    Also distinguish ARDUINO_VCC from filtered VCC
    [OpenHardwareExG_Shield.sch]
2014-10-18 isolated side of ADuM6000 hooked up
    [OpenHardwareExG_Shield.sch]
2014-10-18 non-isolated side of ADuM6000 hooked up
    [OpenHardwareExG_Shield.sch]
2014-10-18 add test points and NC unused pins
    [OpenHardwareExG_Shield.sch]
2014-10-18 fixed labels and ERC issues
    [OpenHardwareExG_Shield.sch]
2014-10-18 rough draft of a test shield
    [OpenHardwareExG_Shield_Test_Board.sch]
2014-10-25 added kicad symbols for 74HC595PWR and TPS2095D
2014-10-25 added test points for all I/O to the OpenHardwareExG_Shield
    [OpenHardwareExG_Shield.sch]
2014-10-25 Test_Board now uses all the test points for I/O to shield
    [OpenHardwareExG_Shield_Test_Board.sch]
2014-11-02 add pulldown resistors to pogo inputs
    [OpenHardwareExG_Shield_Test_Board.sch]
2014-11-02 added jumper block for input of calibration signals
    [OpenHardwareExG_Shield_Test_Board.sch]
2014-11-02 Clarify that all isolation on the test board is actually BOGUS
    [OpenHardwareExG_Shield_Test_Board.sch]
2014-11-08 fix some overlapping labels
    [OpenHardwareExG_Shield_Test_Board.sch]
2014-11-08 add non-isolated powerlines to test board test signal header
    [OpenHardwareExG_Shield_Test_Board.sch]
2014-11-08 starting to choose footprints
    [OpenHardwareExG_Shield.sch]
2014-11-08 add footprints for SMD headers and pogopads
    [OpenHardwareExG_Shield.kicad_pcb, OpenHardwareExG_Shield.sch]
2014-11-08 add pogo-pin base footprints to test board
2014-11-09 filled out footprints for remaining test board parts
    [OpenHardwareExG_Shield_Test_Board.kicad_pcb]
2014-11-30 add footprints to schematics
    [OpenHardwareExG_Shield.sch, OpenHardwareExG_Shield_Test_Board.sch]
2014-11-30 update notes, footprints on schematic
    [OpenHardwareExG_Shield.sch]
2014-11-30 first cut at a 1299 version of a BOM
    [OpenHardwareExG_Shield-1299.mouser.bom.csv]
2014-12-13 add components to kicad_pcb
    [OpenHardwareExG_Shield.kicad_pcb]
2014-12-14 start actually laying out the board
    Added a 0 Ohm resistor to clarify the star-grounding of AGND and DGND,
    we will likely remove this later.
    [OpenHardwareExG_Shield.kicad_pcb, OpenHardwareExG_Shield.sch]
2015-01-03 checkpoint: untangle isolated/non-isolated rats-nest
    Also, remove resistors from data lines which are now short.
    [OpenHardwareExG_Shield.kicad_pcb, OpenHardwareExG_Shield.sch]
2015-01-03 checkpoint: layout analog capacitors
    [OpenHardwareExG_Shield.kicad_pcb, OpenHardwareExG_Shield.sch]
2015-01-03 east and south sides of ADS1299 mostly connected
    [OpenHardwareExG_Shield.kicad_pcb]
2015-01-10 initial layout of filter resistors and capacitors
    [OpenHardwareExG_Shield.kicad_pcb, OpenHardwareExG_Shield.sch]
2015-01-10 connect filter to ADS
    [OpenHardwareExG_Shield.kicad_pcb, OpenHardwareExG_Shield.sch]
2015-01-10 wired up most of power
    [OpenHardwareExG_Shield.kicad_pcb, OpenHardwareExG_Shield.sch]
2015-01-18 move GPIO north, begin to cinch-in south end footprints
    [OpenHardwareExG_Shield.kicad_pcb]
2015-01-18 lay tracks for south end
    [OpenHardwareExG_Shield.kicad_pcb]
2015-01-25 add footprint for PIN_ARRAY_7x1
2015-01-25 place GPIO PINS and digital test-points
    [OpenHardwareExG_Shield.kicad_pcb, OpenHardwareExG_Shield.sch]
2015-01-25 move regulator north of power isolator
    [OpenHardwareExG_Shield.kicad_pcb]
2015-02-07 add 18x1 connector
2015-02-07 switch EEG header from 2-row to 18x1 row
    [OpenHardwareExG_Shield.sch]
2015-02-07 place EEG header and testpoints
    [OpenHardwareExG_Shield.kicad_pcb]
2015-02-07 connect the EEG inputs to the chip, via the filter
    [OpenHardwareExG_Shield.kicad_pcb]
2015-02-07 sketch placement of pre-isolated logic
    [OpenHardwareExG_Shield.kicad_pcb]
2015-02-07 ground planes on isolated side of board
    [OpenHardwareExG_Shield.kicad_pcb, OpenHardwareExG_Shield.sch]
2015-02-07 start to lay out power planes
    [OpenHardwareExG_Shield.kicad_pcb, OpenHardwareExG_Shield.sch]
2015-02-14 power planes finished on isolated side
    [OpenHardwareExG_Shield.kicad_pcb, OpenHardwareExG_Shield.sch]
2015-02-14 first cut at non-isolated side of board
    [OpenHardwareExG_Shield.kicad_pcb]
2015-02-14 design rules check passes on board file
    [OpenHardwareExG_Shield.kicad_pcb, OpenHardwareExG_Shield.sch]
2015-02-14 add fiducial marks
    [OpenHardwareExG_Shield.kicad_pcb]
2015-02-14 addeddrill holes; adjustments needed
    [OpenHardwareExG_Shield.kicad_pcb]
2015-02-14 trying to improve the kicad arduino header mod file
2015-02-14 we need to re-draw power planes next
    [OpenHardwareExG_Shield.kicad_pcb]
2015-02-21 matched pin locations to kicad numbers in converted eagle file
    eagle:
    http://arduino.cc/en/Main/ArduinoBoardUno
    converted with:
    https://github.com/DanChianucci/Eagle2Kicad
2015-02-21 add a arduino_shield_with_holes drilled module
2015-02-21 using newer arduino_shield_with_holes footprint
    pins now in better location
    [OpenHardwareExG_Shield.kicad_pcb, OpenHardwareExG_Shield.sch]
2015-03-01 new board edges, pin alignment, labels
    [OpenHardwareExG_Shield.kicad_pcb]
2015-03-07 Moved labels out from underneath components
    [OpenHardwareExG_Shield.kicad_pcb]
2015-03-07 tidy some labels
    [OpenHardwareExG_Shield.kicad_pcb]
2015-03-07 tidy back labels, add no-mans lines
    [OpenHardwareExG_Shield.kicad_pcb]
2015-03-07 the TI TPS2095D datasheet suggests "shield shorted" should be inverted
    [OpenHardwareExG_Shield_Test_Board.sch]
2015-03-07 inital testpoints, pre-pogo
    [OpenHardwareExG_Shield-append.kicad_pcb]
2015-03-07 renumber pogo-points to have same Px as main board test points
    [OpenHardwareExG_Shield_Test_Board.sch]
2015-03-07 move pads to top side of board
    [OpenHardwareExG_Shield-append.kicad_pcb, OpenHardwareExG_Shield_Test_Board.kicad_pcb]
2015-03-07 swap-in pogo-pins for pads
    [OpenHardwareExG_Shield_Test_Board.kicad_pcb]
2015-03-07 checkpoint tesh-harness pcb, components separated
    [OpenHardwareExG_Shield_Test_Board.kicad_pcb, OpenHardwareExG_Shield_Test_Board.sch]
2015-03-07 re-order signal ladder for easier physical layout
    [OpenHardwareExG_Shield_Test_Board.kicad_pcb, OpenHardwareExG_Shield_Test_Board.sch]
2015-03-07 untangle the rats nest some
    [OpenHardwareExG_Shield_Test_Board.kicad_pcb, OpenHardwareExG_Shield_Test_Board.sch]
2015-03-14 move connectors onto .1 grid
    [OpenHardwareExG_Shield_Test_Board.kicad_pcb]
2015-03-14 power chips on isolated side of test harness from the board under test
    [OpenHardwareExG_Shield_Test_Board.kicad_pcb, OpenHardwareExG_Shield_Test_Board.sch]
2015-03-14 routing of test harness half done
    [OpenHardwareExG_Shield_Test_Board.kicad_pcb, OpenHardwareExG_Shield_Test_Board.sch]
2015-03-21 finish initial routing of the test board
    [OpenHardwareExG_Shield_Test_Board.kicad_pcb, OpenHardwareExG_Shield_Test_Board.sch]
2015-03-21 improve routing of ground and power; improve planes on BOGUS_ISO side
    [OpenHardwareExG_Shield_Test_Board.kicad_pcb]
2015-03-28 improved routing and planes on test board
    [OpenHardwareExG_Shield_Test_Board.kicad_pcb]
2015-03-28 move some labels
    [OpenHardwareExG_Shield_Test_Board.kicad_pcb]
2015-03-28 make component values invisible on silk
    [OpenHardwareExG_Shield_Test_Board.kicad_pcb]
2015-03-28 move some lables
    [OpenHardwareExG_Shield_Test_Board.kicad_pcb]
2015-03-28 finish labels on test board
    [OpenHardwareExG_Shield_Test_Board.kicad_pcb]
2015-03-28 adjust labels on main board
    [OpenHardwareExG_Shield.kicad_pcb]
2015-04-11 add the first riser board of test harness
    [OpenHardwareExG_Shield_Test_Board_Riser_Base.kicad_pcb]
2015-04-11 add top riser board (with tabs) of test harness
    [OpenHardwareExG_Shield_Test_Board_Riser_Top.kicad_pcb]
2015-04-11 silk screen for main board done
    [OpenHardwareExG_Shield.kicad_pcb]
2015-04-18 add ground zone fills top and bottom; add bottom silk text
    [OpenHardwareExG_Shield.kicad_pcb]
2015-04-18 notch-out ground zone to ensure AGND+DGND star-ground
    [OpenHardwareExG_Shield.kicad_pcb]
2015-04-18 add gerber files
    [OpenHardwareExG_Shield-B_Cu.gbl, OpenHardwareExG_Shield-B_Mask.gbs, OpenHardwareExG_Shield-B_Paste.gbp, OpenHardwareExG_Shield-B_SilkS.gbo, OpenHardwareExG_Shield-Edge_Cuts.gbr, OpenHardwareExG_Shield-F_Cu.gtl, OpenHardwareExG_Shield-F_Mask.gts, OpenHardwareExG_Shield-F_Paste.gtp]
2015-04-18 fix schematic text to refer to correct resistor
    [OpenHardwareExG_Shield.sch]
2015-04-18 update BOM
2015-04-25 add rev. 0.0 to silk screen
    [OpenHardwareExG_Shield.kicad_pcb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]
2015-04-25 replace triac, new manufacture part number does not include a comma
    [OpenHardwareExG_Shield-1299.mouser.bom.csv, OpenHardwareExG_Shield.kicad_pcb, OpenHardwareExG_Shield.sch]
2015-04-25 split BOMs into through-hole and surface-mount BOMs
2015-05-02 add addition text and CERN OHL logos (on copper layer, too)
    [OpenHardwareExG_Shield_Test_Board.kicad_pcb]
2015-05-02 add extra set of tabs
    [OpenHardwareExG_Shield_Test_Board_Riser_Top.kicad_pcb]
2015-05-02 all test-harness boards on one panel
    [OpenHardwareExG_Shield_Test_Board_all_panelled.kicad_pcb]
2015-05-02 gerbers for test-harness
    [OpenHardwareExG_Shield_Test_Board_all_panelled-B_Cu.gbl, OpenHardwareExG_Shield_Test_Board_all_panelled-B_Mask.gbs, OpenHardwareExG_Shield_Test_Board_all_panelled-B_Paste.gbp, OpenHardwareExG_Shield_Test_Board_all_panelled-Edge_Cuts.gbr, OpenHardwareExG_Shield_Test_Board_all_panelled-F_Cu.gtl, OpenHardwareExG_Shield_Test_Board_all_panelled-F_Mask.gts, OpenHardwareExG_Shield_Test_Board_all_panelle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]
2015-05-02 BOM for Test_Board
    [OpenHardwareExG_Shield_Test_Board.bom.csv]
2015-05-23 VCAP capacitors do not match datasheet, but work fine for us.
    [OpenHardwareExG_Shield.sch]
2015-06-07 Start on firmware for shield test board
2015-06-13 enumerate Pogos and remaining Arduino PIN values
2015-07-26 fix PWRDWN and RESET: tie HIGH not LOW. D'oh!
    [OpenHardwareExG_Shield.sch]
2015-07-26 notes regarding prototype board errors
2015-08-01 ADS129x pins tied high should tie to 3.3V_ISO (not VIN_ISO)
    [OpenHardwareExG_Shield.sch]
2015-08-01 fixup PCB to tie ~PWDN~ and ~RESET~ to 3.3V_ISO
    [OpenHardwareExG_Shield.kicad_pcb]
2015-08-01 fix the crowbar on schematic
    PCB still needs fixing
    [OpenHardwareExG_Shield.sch]
2015-08-14 add footprint to 330uF C73
    [OpenHardwareExG_Shield.sch]
2015-08-14 just drop C73 on the pcb, will need layout work
    [OpenHardwareExG_Shield.kicad_pcb]
2015-08-30 T49D337K010ATE150 is a "D" footprint, not "E"
    [OpenHardwareExG_Shield.sch]
2015-08-30 add note to recommend female header for GPIO (P22)
    [OpenHardwareExG_Shield.sch]
2015-08-30 add C73 (330uF) to PCB
    [OpenHardwareExG_Shield.kicad_pcb]
2015-08-30 version bump to r0.1
    [OpenHardwareExG_Shield.kicad_pcb]
2015-08-30 move via for C73 to the power plane
    [OpenHardwareExG_Shield.kicad_pcb]
2015-08-30 rev 0.1 gerbers
    [OpenHardwareExG_Shield-B_Cu.gbl, OpenHardwareExG_Shield-B_Mask.gbs, OpenHardwareExG_Shield-B_Paste.gbp, OpenHardwareExG_Shield-B_SilkS.gbo, OpenHardwareExG_Shield-Edge_Cuts.gbr, OpenHardwareExG_Shield-F_Cu.gtl, OpenHardwareExG_Shield-F_Mask.gts, OpenHardwareExG_Shield-F_Paste.gtp]
2015-08-30 Update drill report files
2015-08-30 sketch of rev_0.1 bom
    [OpenHardwareExG_Shield-rev_0.1.csv]
2015-08-30 note the need to fix footprint
2015-08-30 should just be date updates
    [OpenHardwareExG_Shield-B_Cu.gbl, OpenHardwareExG_Shield-B_Mask.gbs, OpenHardwareExG_Shield-B_Paste.gbp, OpenHardwareExG_Shield-B_SilkS.gbo, OpenHardwareExG_Shield-Edge_Cuts.gbr, OpenHardwareExG_Shield-F_Cu.gtl, OpenHardwareExG_Shield-F_Mask.gts, OpenHardwareExG_Shield-F_Paste.gtp]
2015-08-30 fix C43 footprint
    [OpenHardwareExG_Shield-B_Cu.gbl, OpenHardwareExG_Shield-B_Mask.gbs, OpenHardwareExG_Shield-B_Paste.gbp, OpenHardwareExG_Shield-B_SilkS.gbo, OpenHardwareExG_Shield-Edge_Cuts.gbr, OpenHardwareExG_Shield-F_Cu.gtl, OpenHardwareExG_Shield-F_Mask.gts, OpenHardwareExG_Shield-F_Paste.gtp]
2015-09-13 better debug printing
2015-09-13 drive A4 (GND_BOGUS_ISO)
2015-09-13 cheesy Makefile to use Arduino-1.6 commandline build
2015-09-18 print out the unused shift data
2015-09-27 first sample test code
2015-10-03 do not apply solder to POGO_PAD test points
    [OpenHardwareExG_Shield-B_Cu.gbl, OpenHardwareExG_Shield-B_Mask.gbs, OpenHardwareExG_Shield-B_Paste.gbp, OpenHardwareExG_Shield-B_SilkS.gbo, OpenHardwareExG_Shield-Edge_Cuts.gbr, OpenHardwareExG_Shield-F_Cu.gtl, OpenHardwareExG_Shield-F_Mask.gts, OpenHardwareExG_Shield-F_Paste.gtp]
2015-11-15 working test detecting 5V shorted to GND
2015-12-05 delay before checking for short; allow capacitors to charge
2015-12-05 connect DGND_ISO to DGND (DOH!); convert to KiCad 4
    [OpenHardwareExG_Shield-B.Cu.gbl, OpenHardwareExG_Shield-B.Mask.gbs, OpenHardwareExG_Shield-B.Paste.gbp, OpenHardwareExG_Shield-B.SilkS.gbo, OpenHardwareExG_Shield-B_Cu.gbl, OpenHardwareExG_Shield-B_Mask.gbs, OpenHardwareExG_Shield-B_Paste.gbp, OpenHardwareExG_Shield-B_SilkS.gbo]
2015-12-11 add additional delay between checking for short and checking voltage
2015-12-11 drive RESIST_GND_ISO high and low (and check)
2016-01-14 sketch in simulating board bellow
2016-01-24 replace fudicial marks with new library modules
    removes the paste layer
    also added fudicials to the back
    and one near the ADS129x
    [OpenHardwareExG_Shield-B.CrtYd.gbr, OpenHardwareExG_Shield-B.Cu.gbl, OpenHardwareExG_Shield-B.Mask.gbs, OpenHardwareExG_Shield-B.SilkS.gbo, OpenHardwareExG_Shield-Edge.Cuts.gm1, OpenHardwareExG_Shield-F.CrtYd.gbr, OpenHardwareExG_Shield-F.Cu.gtl, OpenHardwareExG_Shield-F.Mask.gts]
2016-01-24 add test for simulate board below; refactor default states
2016-01-24 add test for simulate board below and slave selected
2016-01-24 add test for simulate board below and slave and master selected
2016-01-24 break early from blink_error if "go" button is pressed
2016-03-13 use SPI, check chip ID from ADS1299
2016-03-13 extract SPI setup and teardown functions
2016-03-20 test for DRDY and read a frame from ADS and test for "Magic"
2016-03-21 pull in the ads1298.h from OpenHardwareExG
    we are using the ADS1299, so some values are not the same ...
    we will need to fix that eventually ....
    [ads1298.h]
2016-04-02 add notes about connecting test points for next rev
    [OpenHardwareExG_Shield.sch, OpenHardwareExG_Shield_Test_Board.sch]
2016-06-04 bump PCB version to 0.2
    [OpenHardwareExG_Shield.kicad_pcb]
2016-06-04 update ancillary-files to v0.2
    [OpenHardwareExG_Shield-B.CrtYd.gbr, OpenHardwareExG_Shield-B.Cu.gbl, OpenHardwareExG_Shield-B.Mask.gbs, OpenHardwareExG_Shield-B.Paste.gbp, OpenHardwareExG_Shield-B.SilkS.gbo, OpenHardwareExG_Shield-Edge.Cuts.gm1, OpenHardwareExG_Shield-F.CrtYd.gbr, OpenHardwareExG_Shield-F.Cu.gtl]
2016-06-04 add expected v0.2 GoldPhoenix BOM
    [OpenHardwareExG_Shield_v02_GoldPhoenix_Mouser_BOM.csv]
2016-07-17 pcb v0.2.1: fix text alignement of multi-line text
    It seems that the switch to KiCAD v4 may have changed
    the way multi-line text items are aligned on PCBs.
    This converts all multi-line to multiple single line items.
    [OpenHardwareExG_Shield.kicad_pcb]
2016-07-17 remove gerbers for rev 0.2, they contained silkscreen errors
    [OpenHardwareExG_Shield-B.CrtYd.gbr, OpenHardwareExG_Shield-B.Cu.gbl, OpenHardwareExG_Shield-B.Mask.gbs, OpenHardwareExG_Shield-B.Paste.gbp, OpenHardwareExG_Shield-B.SilkS.gbo, OpenHardwareExG_Shield-Edge.Cuts.gm1, OpenHardwareExG_Shield-F.CrtYd.gbr, OpenHardwareExG_Shield-F.Cu.gtl]
2016-07-23 add POGO_HEAD_HOLE and update "connectors" library to kicad v4
2016-07-23 expand test jig board to stabilize pogo pins
    [OpenHardwareExG_Shield_Test_Board_Riser_Base.kicad_pcb]
2016-07-23 gerbers for new test harness reiser board
    [OpenHardwareExG_Shield_Test_Board_Riser_Base-Edge.Cuts.gm1, OpenHardwareExG_Shield_Test_Board_Riser_Base-F.SilkS.gto, OpenHardwareExG_Shield_Test_Board_Riser_Base-NPTH.drl]
2016-08-30 add pulldown resistors for GPIOs
    [OpenHardwareExG_Shield.kicad_pcb, OpenHardwareExG_Shield.sch]
2016-09-04 add label to Arduino header pins 5, 6, and 7
    [OpenHardwareExG_Shield.kicad_pcb]
2016-09-04 adjust label locations
    [OpenHardwareExG_Shield.kicad_pcb]
2017-06-24 move test harness ancillary files to ancillary-files-test-harness
    [OpenHardwareExG_Shield_Test_Board_Riser_Base-Edge.Cuts.gm1, OpenHardwareExG_Shield_Test_Board_Riser_Base-F.SilkS.gto, OpenHardwareExG_Shield_Test_Board_Riser_Base-NPTH.drl]
2017-06-24 adding Gerber and drill files
    [OpenHardwareExG_Shield-B.CrtYd.gbr, OpenHardwareExG_Shield-B.Cu.gbl, OpenHardwareExG_Shield-B.Mask.gbs, OpenHardwareExG_Shield-B.Paste.gbp, OpenHardwareExG_Shield-B.SilkS.gbo, OpenHardwareExG_Shield-Edge.Cuts.gm1, OpenHardwareExG_Shield-F.CrtYd.gbr, OpenHardwareExG_Shield-F.Cu.gtl]
2017-07-28 move Test_Harness files into their own clearly separate directory
    [OpenHardwareExG_Shield_Test_Board.bom.csv, OpenHardwareExG_Shield_Test_Board.kicad_pcb, OpenHardwareExG_Shield_Test_Board.sch, OpenHardwareExG_Shield_Test_Board_Riser_Base.kicad_pcb, OpenHardwareExG_Shield_Test_Board_Riser_Top.kicad_pcb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]
2017-07-28 adjust for new version of KiCAD, copy in lib from main project
    [OpenHardwareExG_Shield_Test_Board.sch]
2026-10-25 Added PDF of shield schematic
    Generated with KiCad 5.0.2
