OpenElectronicsLab/OpenHardwareExG_Shield/(notices)

Notices in the files:
OpenHardwareExG_Shield_Test_Harness/kicad-files/OpenHardwareExG_Shield_Test_Board_all_panelled.kicad_pcb:
CERN Open Hardware License v1.2
kicad-files/OpenHardwareExG_Shield.kicad_pcb:
Licensed under CERN OHL v.1.2 or later
